CraigB-spinner/Arcade-Spinner/Pics/200mm_Aluminum_Wheel.jpg

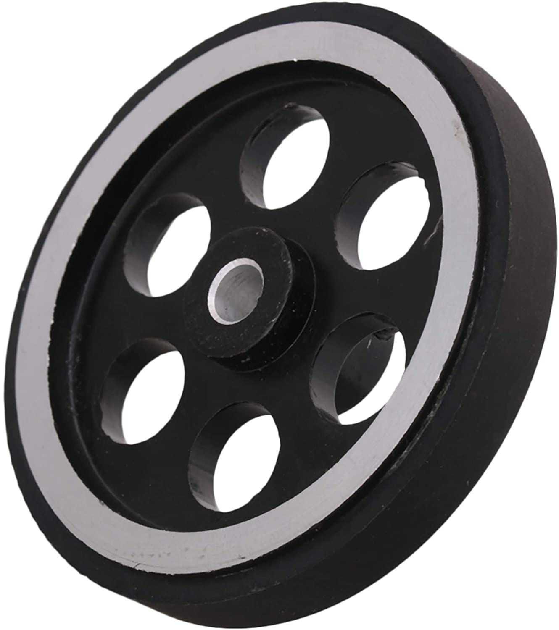
Pics/200mm_Aluminum_Wheel.jpg
