CraigB-spinner/Arcade-Spinner/Pics/200mm_Aluminum_Wheel_2.jpg

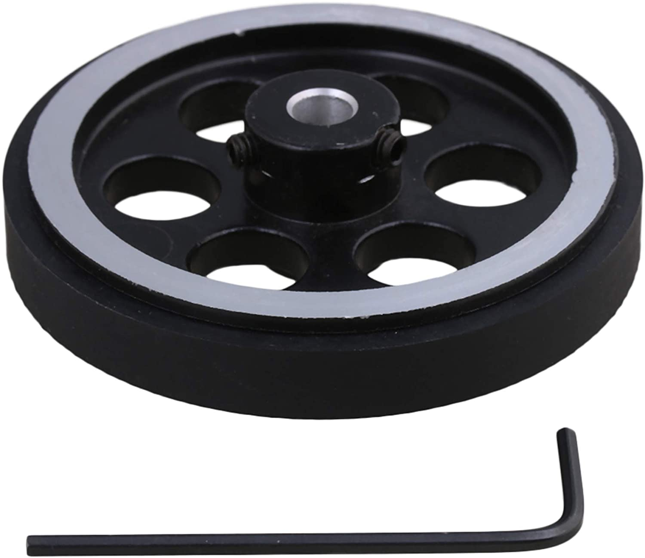
Pics/200mm_Aluminum_Wheel_2.jpg
