CraigB-spinner/Arcade-Spinner/Pics/Adafruit ItsyBitsy - Arduino Micro.jpg

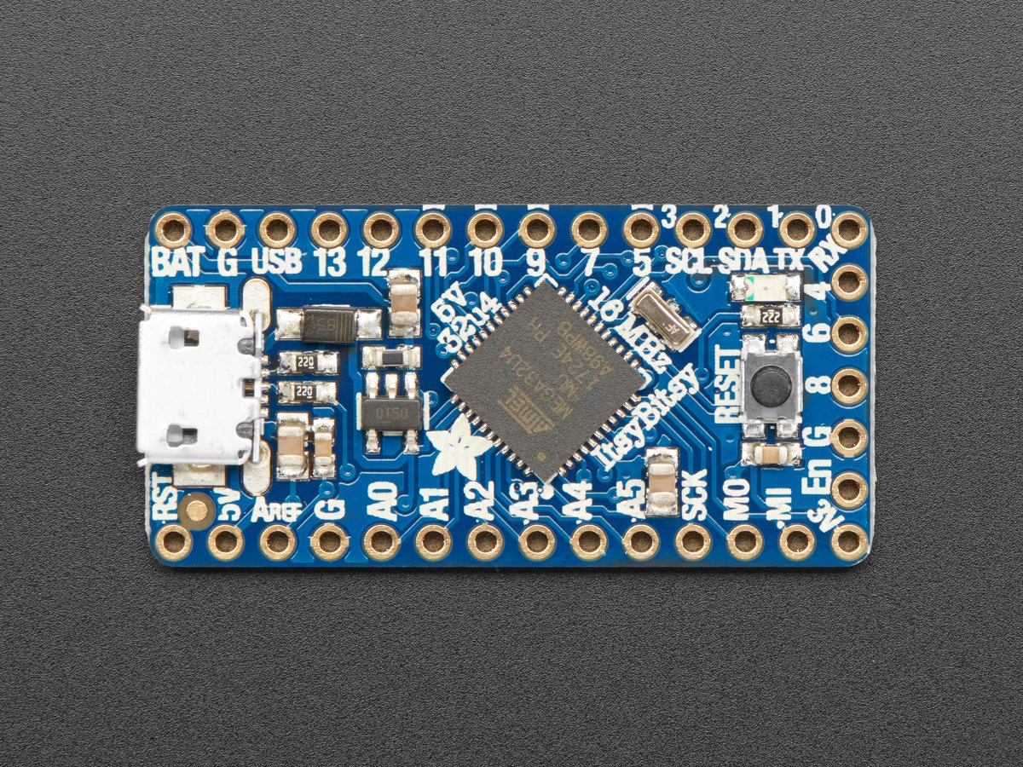
Pics/Adafruit ItsyBitsy - Arduino Micro.jpg
