CraigB-spinner/Arcade-Spinner/Pics/Arduino Micro (Adafruit).jpg

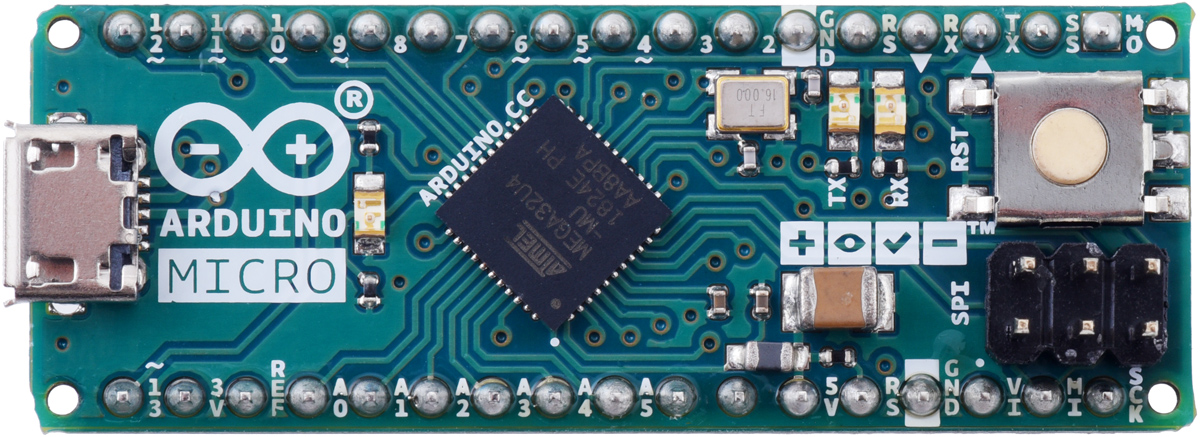
Pics/Arduino Micro (Adafruit).jpg
