CraigB-spinner/Arcade-Spinner/Pics/Arduino Pro Micro Atmega32u4.jpg

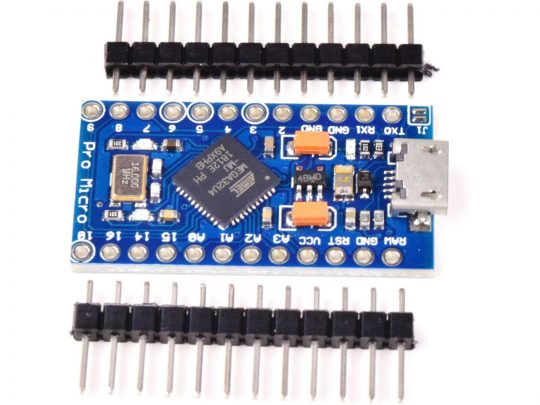
Pics/Arduino Pro Micro Atmega32u4.jpg
