CraigB-spinner/Arcade-Spinner/Pics/Cap_touch.jpg

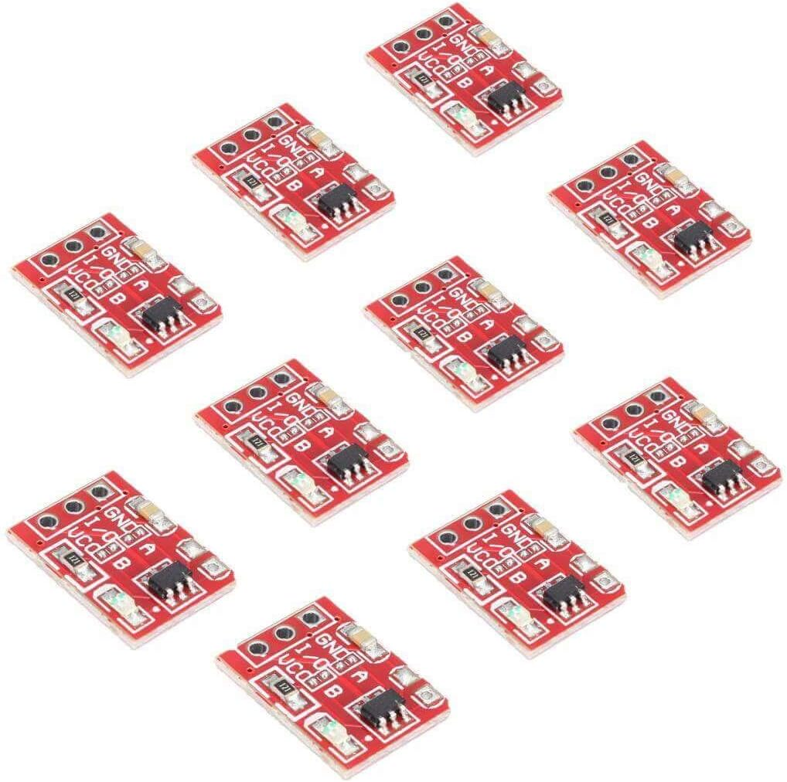
Pics/Cap_touch.jpg
