CraigB-spinner/Arcade-Spinner/Pics/Coin-Play-Exit/IMG_2034.JPG

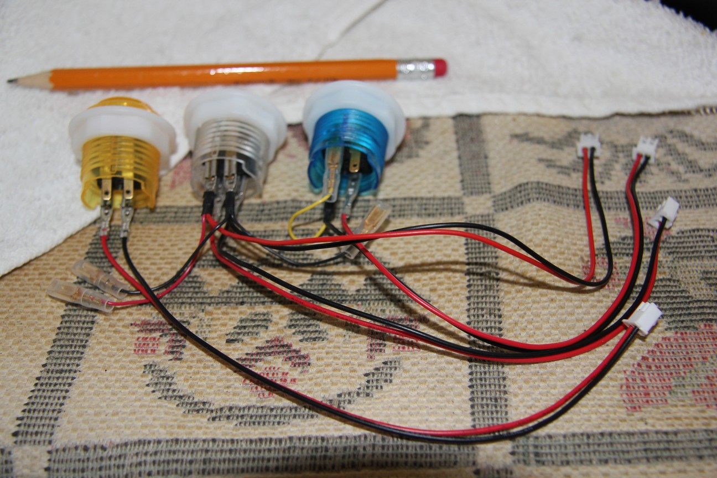
Pics/Coin-Play-Exit/IMG_2034.JPG
