CraigB-spinner/Arcade-Spinner/Pics/Coin-Play-Exit/IMG_2035.JPG

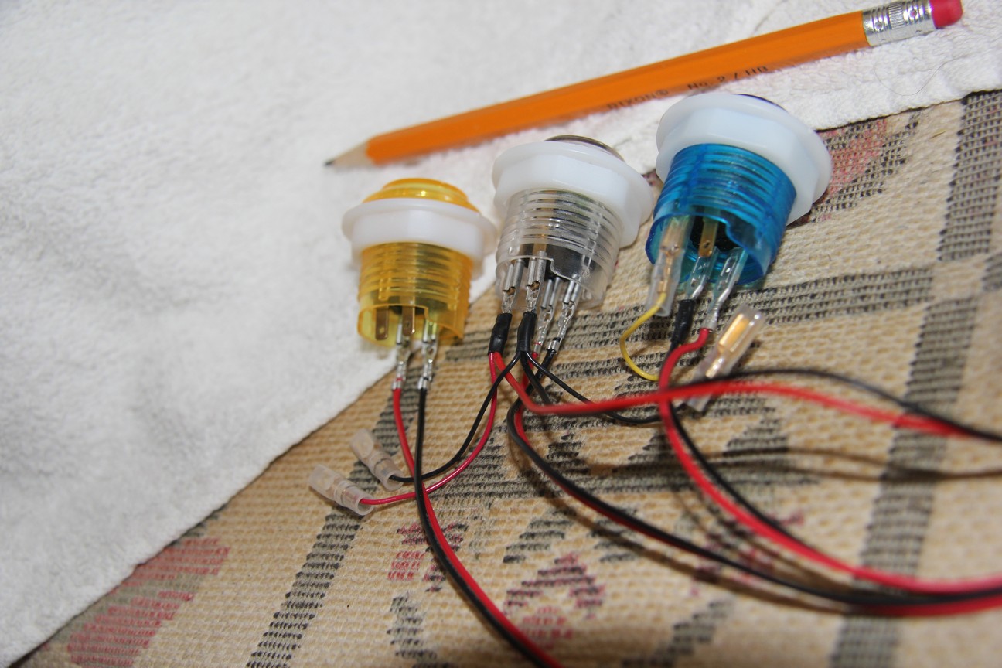
Pics/Coin-Play-Exit/IMG_2035.JPG
