CraigB-spinner/Arcade-Spinner/Pics/CraigB's Spinner.jpg

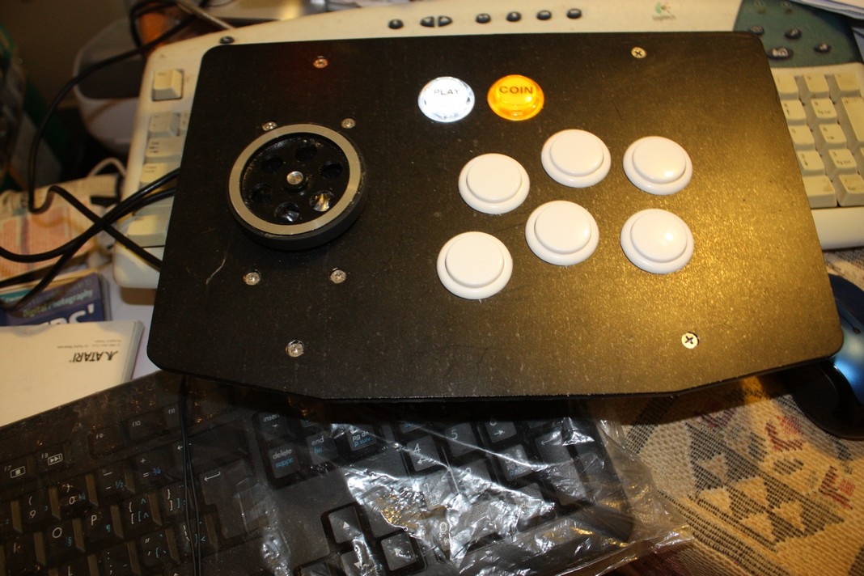
Pics/CraigB's Spinner.jpg
