CraigB-spinner/Arcade-Spinner/Pics/Double Touch.jpg

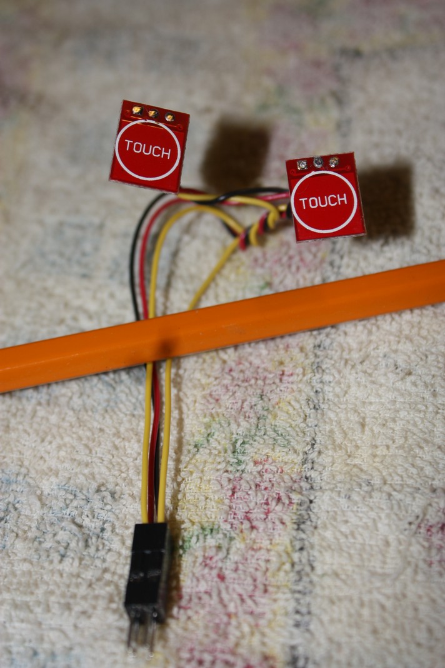
Pics/Double Touch.jpg
