CraigB-spinner/Arcade-Spinner/Pics/Fightbox.jpg

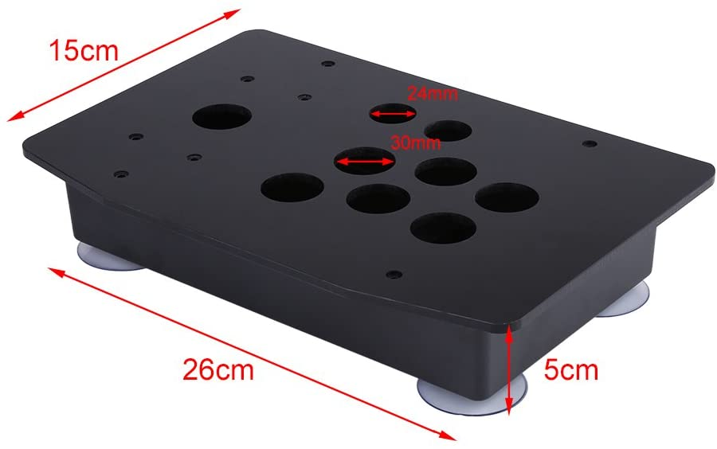
Pics/Fightbox.jpg
