CraigB-spinner/Arcade-Spinner/Pics/Inside guts of spinner.jpg

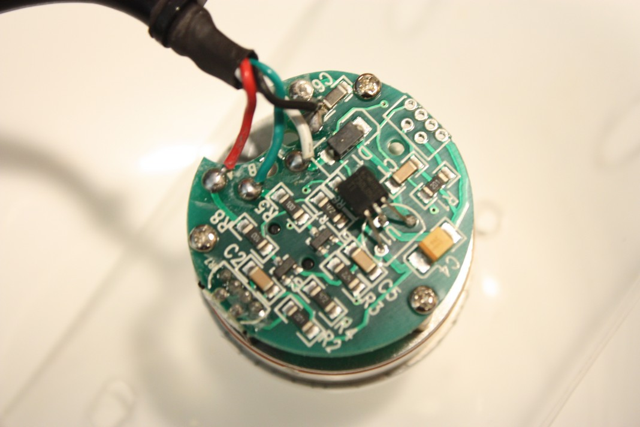
Pics/Inside guts of spinner.jpg
