CraigB-spinner/Arcade-Spinner/Pics/Mxuteuk_Black_AL_Knob_Bottom.jpg

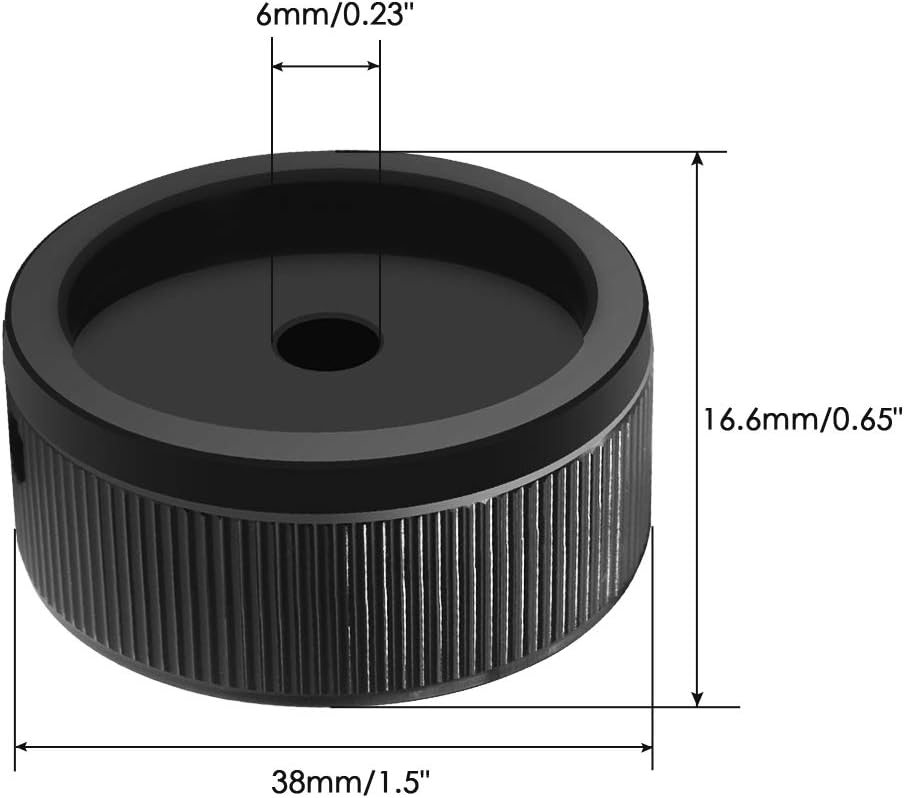
Pics/Mxuteuk_Black_AL_Knob_Bottom.jpg
