CraigB-spinner/Arcade-Spinner/Pics/Mxuteuk_Black_AL_Knob_Side.jpg

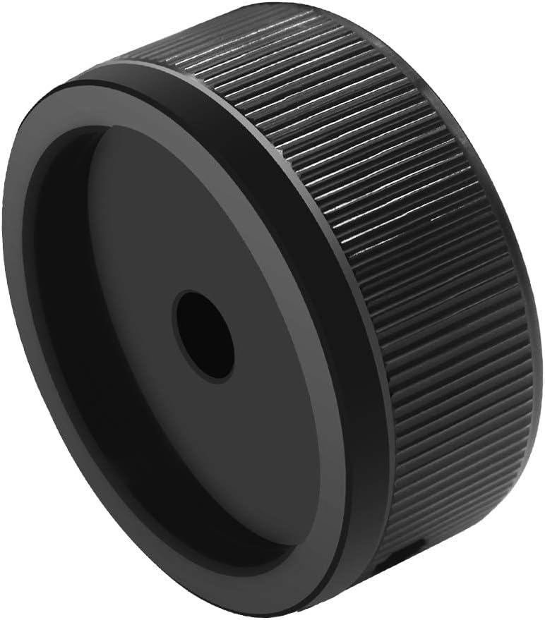
Pics/Mxuteuk_Black_AL_Knob_Side.jpg
