CraigB-spinner/Arcade-Spinner/Pics/Mxuteuk_Black_AL_Knob_Top.jpg

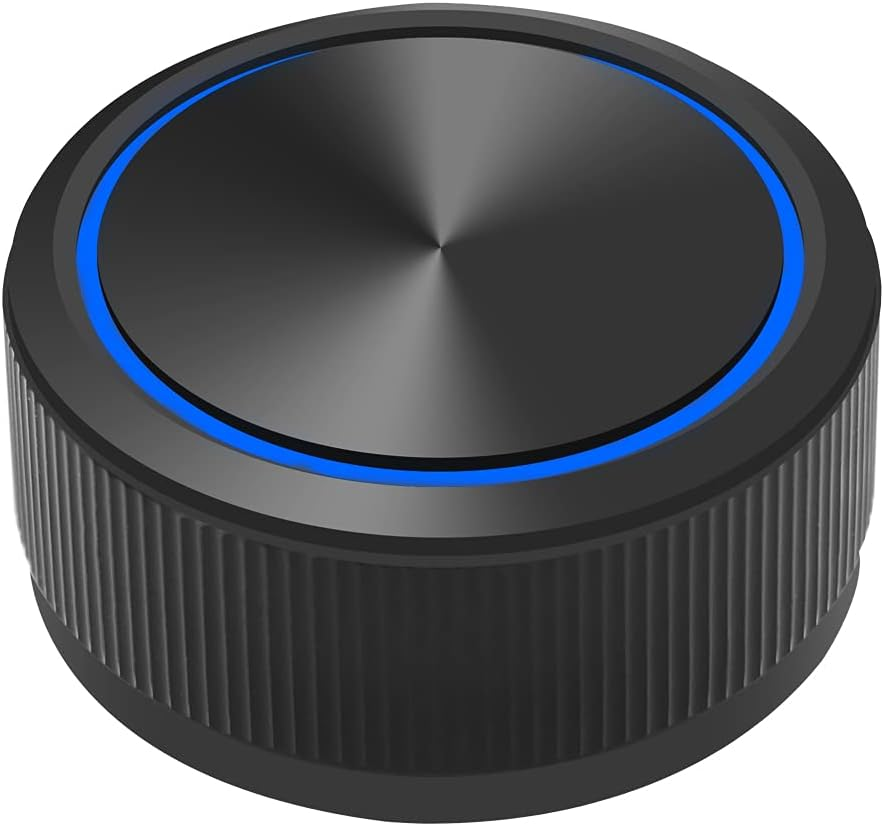
Pics/Mxuteuk_Black_AL_Knob_Top.jpg
