CraigB-spinner/Arcade-Spinner/Pics/Pro_Micro_pinout-Sparkfun-33%.jpg

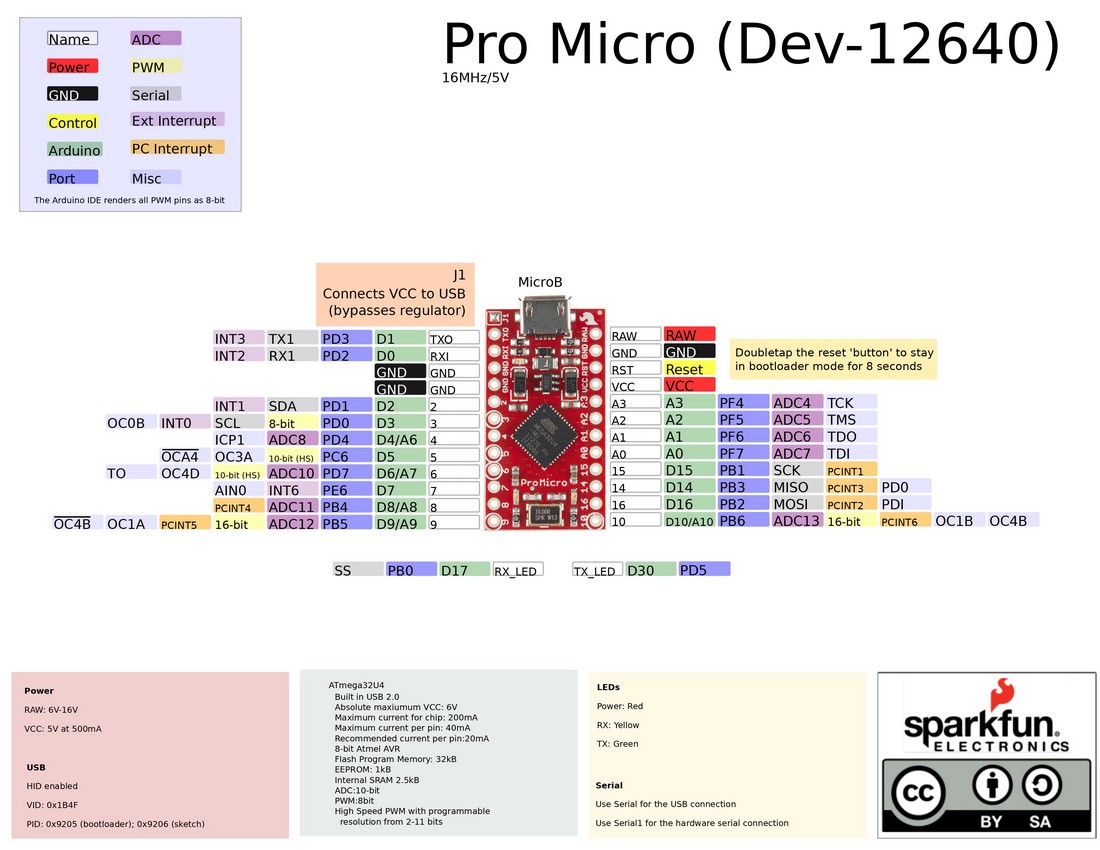
Pics/Pro_Micro_pinout-Sparkfun-33%.jpg
