CraigB-spinner/Arcade-Spinner/Pics/Spin Action Close.jpg

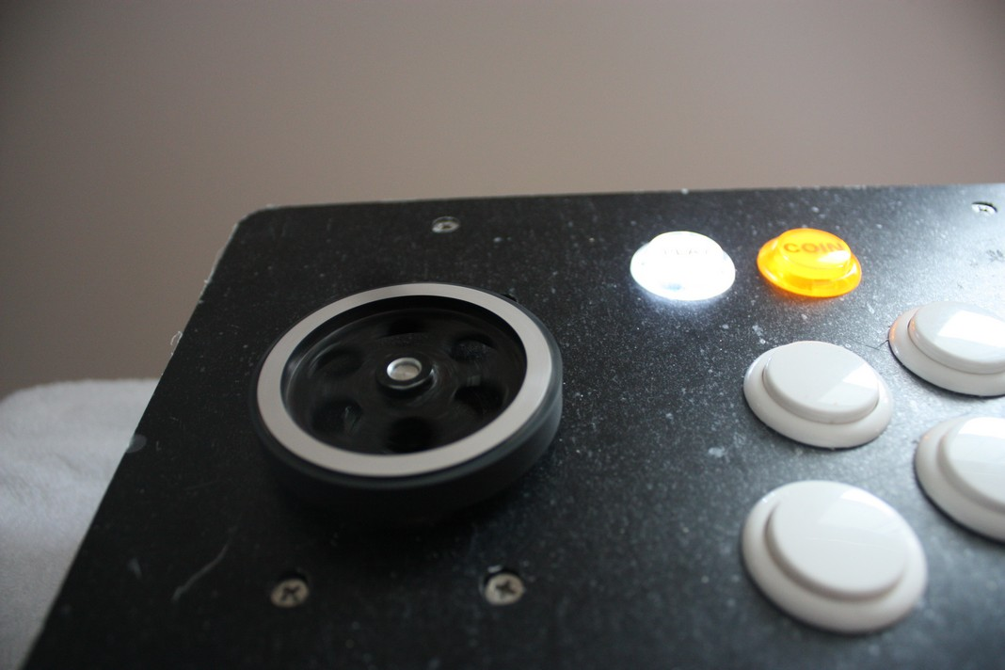
Pics/Spin Action Close.jpg
