CraigB-spinner/Arcade-Spinner/Pics/Spin Action Full.jpg

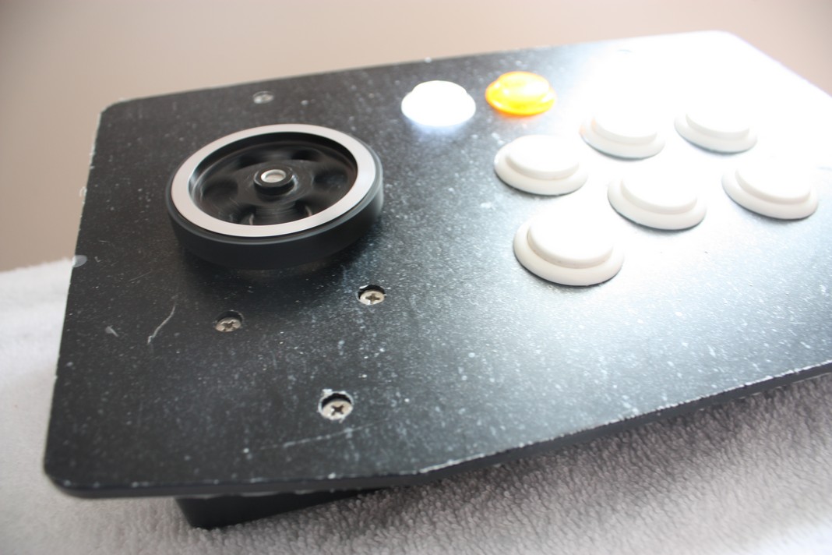
Pics/Spin Action Full.jpg
