CraigB-spinner/Arcade-Spinner/Pics/Spin Full.jpg

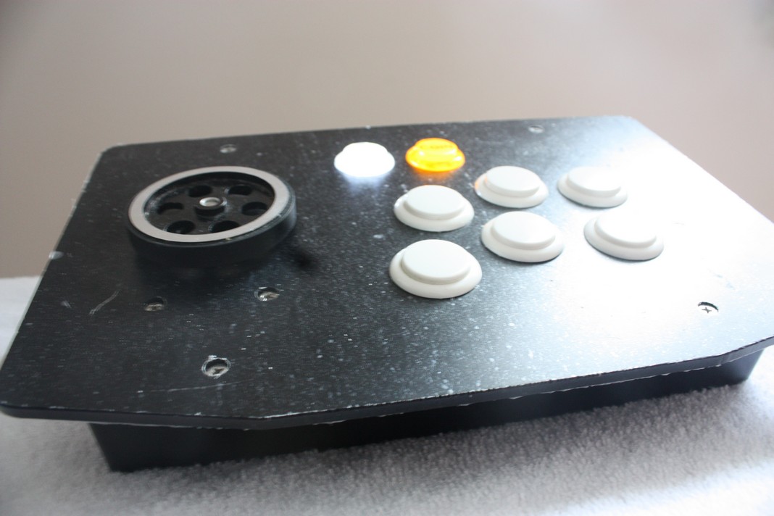
Pics/Spin Full.jpg
