CraigB-spinner/Arcade-Spinner/Pics/Spin HiLite.jpg

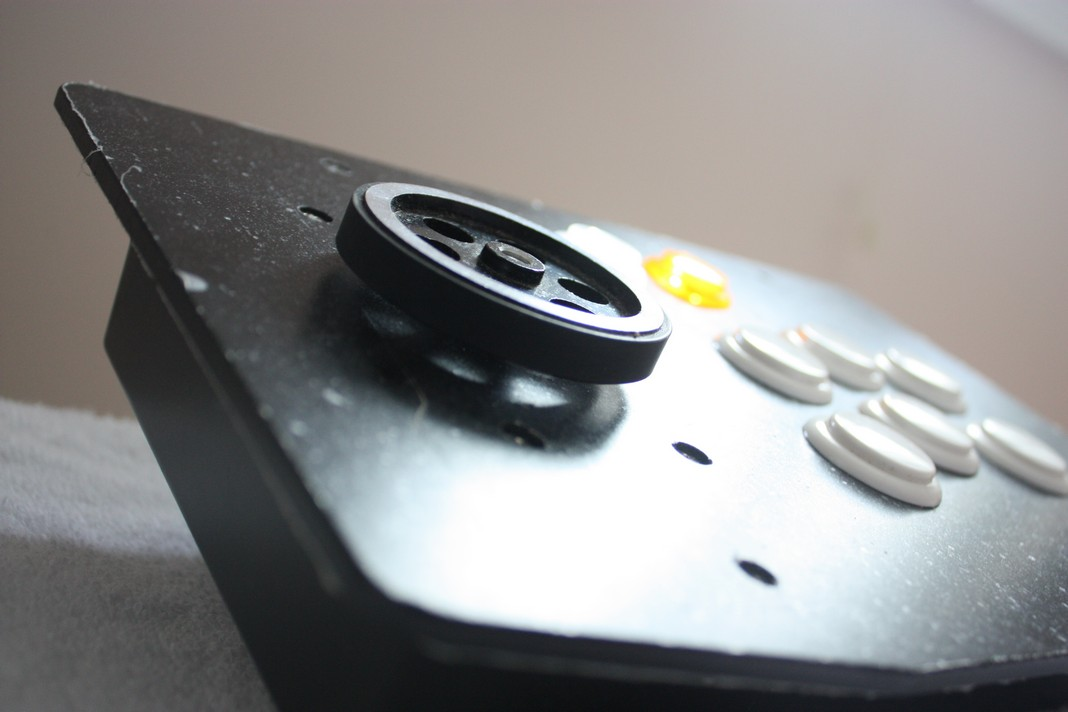
Pics/Spin HiLite.jpg
