CraigB-spinner/Arcade-Spinner/Pics/Spin Shadow.jpg

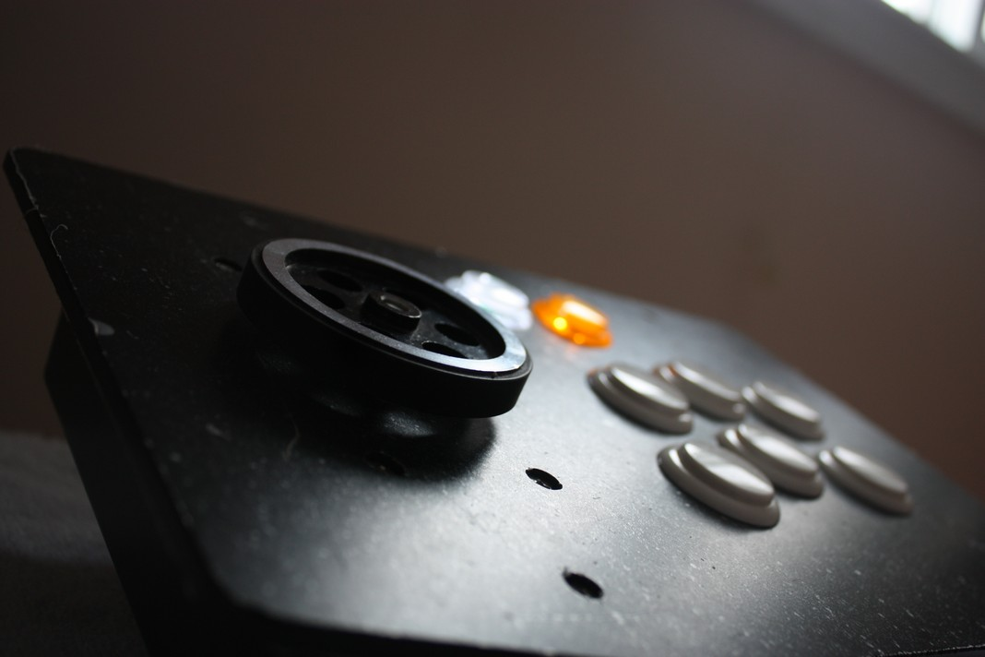
Pics/Spin Shadow.jpg
