CraigB-spinner/Arcade-Spinner/Pics/Spinner Sketch_bb.jpg

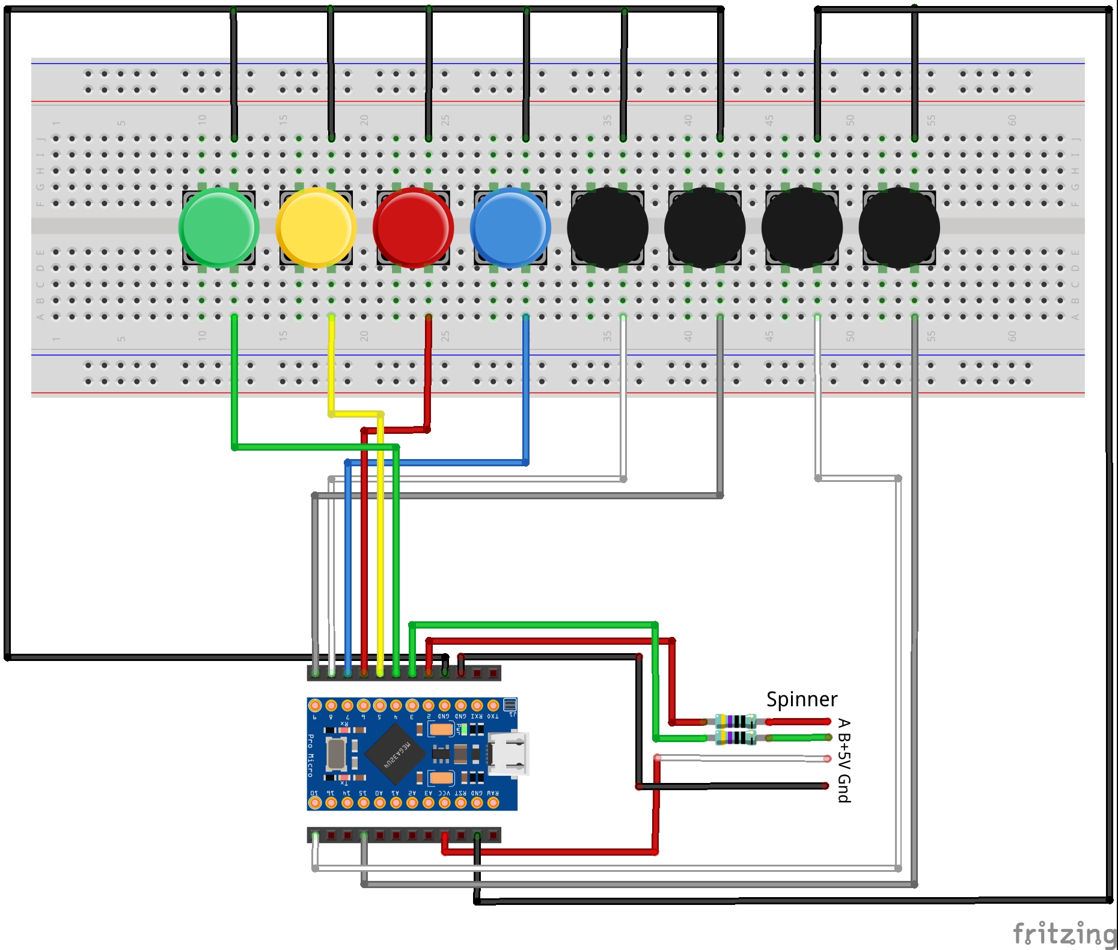
Pics/Spinner Sketch_bb.jpg
