CraigB-spinner/Arcade-Spinner/Pics/Spinner_600ppr.jpg

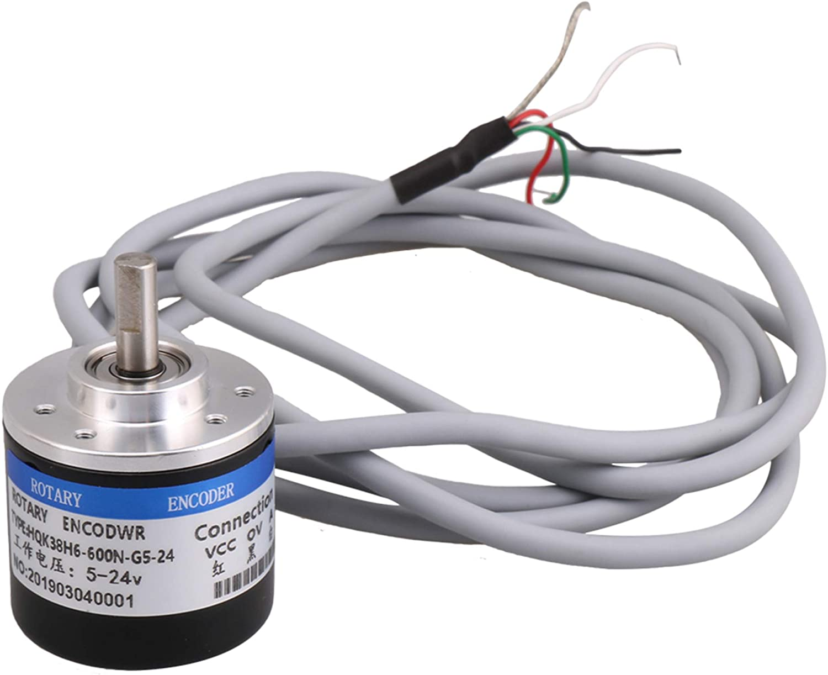
Pics/Spinner_600ppr.jpg
