CraigB-spinner/Arcade-Spinner/Pics/Spinner_600ppr_2.jpg

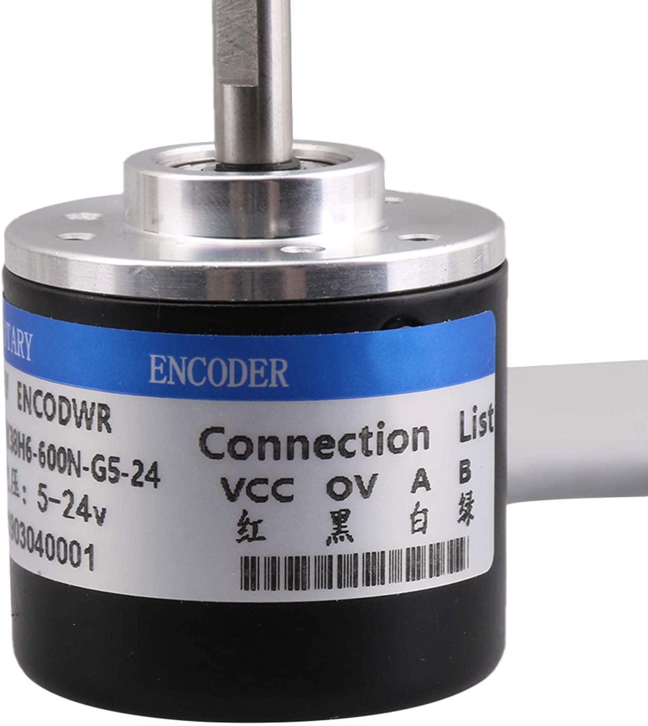
Pics/Spinner_600ppr_2.jpg
