CraigB-spinner/Arcade-Spinner/Pics/TTP223B_chip_side.jpg

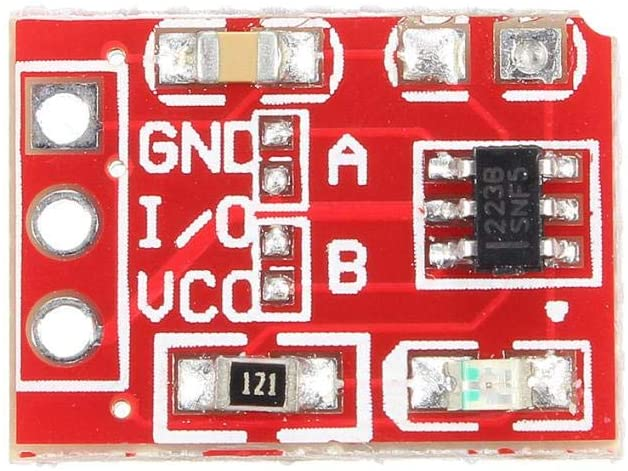
Pics/TTP223B_chip_side.jpg
