CraigB-spinner/Arcade-Spinner/Special Testing Pics/Arduino beauty shot.jpg

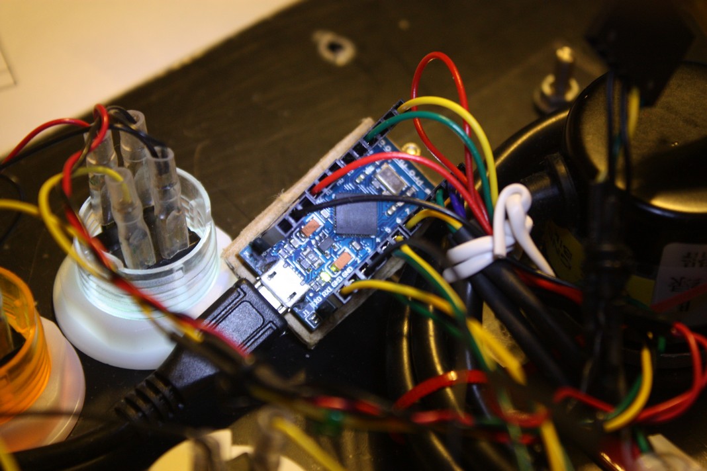
Special Testing Pics/Arduino beauty shot.jpg
