CraigB-spinner/Arcade-Spinner/Special Testing Pics/Inside spaghetti.jpg

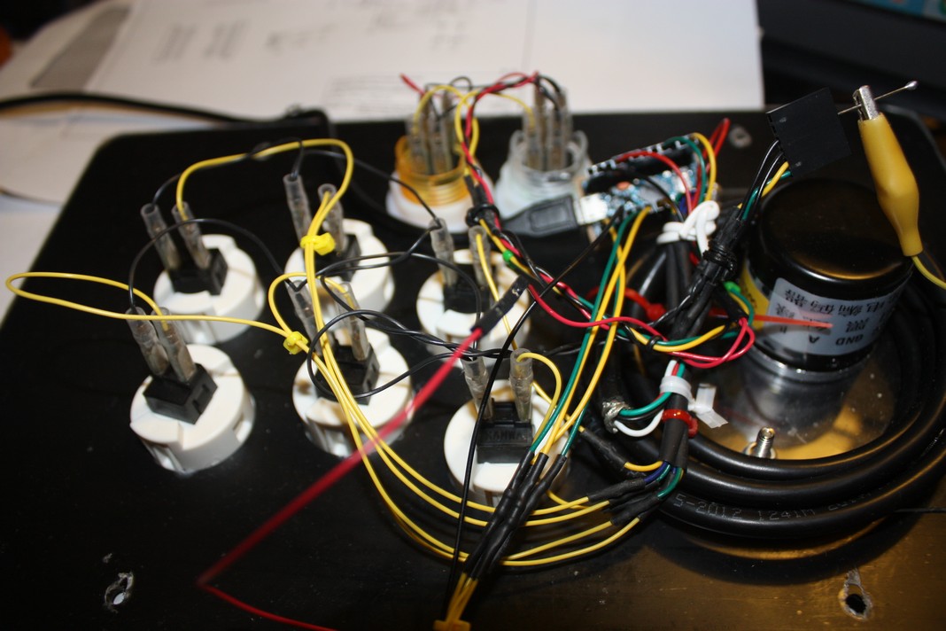
Special Testing Pics/Inside spaghetti.jpg
