CraigB-spinner/Arcade-Spinner/(threads)

Thread 1 (2022-05-21):

want to build: spinner + 2 XY joysticks + buttons (driving controller)

CO-Windler, 2022-05-21:
I want to build a small driving/steering wheel controller compatible particularly with "Hard Drivin" and "Pole Position" variants on MAME, those need an endless 360° steering wheel (i.e. spinner) and 2 analogue "pedals" (brake and accelerator) plus a couple of digital buttons. Particularly "Hard Drivin" additionally needs an analogue XY joystick as a stick shifter, so I would need basically hardware that combines 2 PC joysticks and a trackball/ball mouse (containing 2 rotary encoders).

The device shall not become a fullsize simulator cockpit with steering wheel, but a compact controller similar like the Colecovision "Turbo" steering wheel/"Expansion Module 2". As a yogi I am a floorsitter living in a chairfree home, so it shall not need actual foot pedals (although I own plenty of volume pedals from my music keyboard collection); instead it will likely have pressure sensitive buttons or levers.

Possibly I will mod one of those baby steering wheel toys like this.

[i]Toy Steering Wheel Controller - Mario Kart: Double Dash!![/i]
https://www.youtube.com/watch?v=iNuI0311-qA

In my electronics parts box I also have a tube radio tuning knob assembly with bearing and big flywheel that could become a nice spinner.

(I websearched plenty of commercially available gamepads for for the electronic part but found nothing suitable. Modern PC mice and trackballs have optical sensors those can not easily mechanically separate X and Y motion.)

Can the code be used to handle a spinner+2 analogue joysticks+buttons combination with USB connector for PC?

CraigB-spinner, 2023-03-07:
Yes, Pro Micro has ability for two spinners or one trackball, 10 digital buttons, 4 analogues (2 joysticks or 4 pots)
Sparkfun had an analogue joystick mouse project.
Warning don't overload the rotary encoder bearing with a heavy wheel or you will be buying twice. Think indirect drive through a gear, pulley, chain, or friction wheel. The steering wheel can be supported by its own bushing/bearings.
I used a 200mm (2.5" dia.) rubber/aluminum rotary encoder wheel.

Thread 2 (2022-12-29):

Can I drive Egstarts2 spinner ?

Giandj, 2022-12-29:
Hi CraigB I have a question:
I have an Egstarts2 spinner (normally compatibile only with arcade 1up 12 in 1 board...over 85 euro in Italy...
I have also an arduino Pro Micro..
So the question is Can I use this code To program my Arduino to connect as an Hid Device egstarts2 spinner on my raspberry Pi4 with retropie 4.8.2 and play with arkanoid? Or Egstarts2 spinner is not recognized by your program code (I intend to use tour Code Spinnet without buttons (because on my arcade buttons are already present and I don't need extra buttons mapped over spinner)...
Thank you

Giandj, 2023-01-01:
Hi Craig I have tried your arcade spinner without buttons code with an Arduino Pro Micro 5v , my Arduino is viewed By IDE sw like "Leonardo" and not like pro micro...(impossible ti compie program If I set different arduino board)...
I don't Know who is the producer of my board (my "pro micro" is a blue board not a red like sparkforfun board)...
I have also used Egstarts (working with 3.3V by external power) spinner with pro micro connecting pin 2 and 3 for rotation left or right...but the spinner works only in ONE Direction  right X axis (x++)...tested on my pc...
if i invert pin 2 and 3 works only on left X axis (x--)...what the mistake?
So if i nove clockwise or anticlockwise the spinner moves only in 1 sense...not in back...

Giandj, 2023-01-06:
Hi CraiG finally i tried Mister.ino and now my spinner works well...
My arduino was a clone of pro micro (but not sparkfun red pro micro board)
So after many and many test to configure (What?) Board in IDE software I finally programmed like Arduino Leonardo ...my pro micro 5v 16mhz Atmega32u4  blu board (identical to pro micro red board selled by sparkfun .com) is total compatibile in IDE with Leonardo and programmer must be set in IDE software like "Atmega32U4 as ISP"
Otherwise isn't programmable...
A question I also tried to connect EGstart2 Spinner (normally compatibile with Arcade 1up 12 in 1 board)...but this spinner won't works...
I have also set 512 Pulse per rotation on this spinner but nothing happens why ? Have You an Idea ? In tour spinner.ino or MistEr.ino code I cannot Undarstand at what speed or what frequency Pin 2 and Pin 3 are listened by intetrupt... maybe the Egstarts2 spinner is too low ? Or maybe is because Egstarts2 spinner works with 3.3v ? instead my working (with Mister.ino) rotary encoder use 5v ...
I don't know...

CraigB-spinner, 2023-03-07:
Sorry, usually monitor my second YouTube comments, didn't see message until today.
I posted my code in fall of 2020 from summer/fall of 2019 build of Spinner and Trackball.
The spinner was a four month project, while the trackball was a three month project.

Pro Micro boards, the inventor Sparkfun made a smaller version of Arduino Micro with fewer pins.
Arduino Srl worked will Adafruit to make the Arduino Micro and Adafruit made their version, ItsyBitsy, and of course China has dozens of clones. I used a Chinese clone from universal-solder.ca which is better quality clone of Sparkfun's board. The bootloader Universal Solder uses emulates Sparkfun's bootloader. I have purchased lower quality Chinese Pro Micro clones that use Leonardo's bootloader. You must setup Arduino IDE to communicate to the specific bootloader to work, like calling your kid's name. It is all a learning experience with micro chip shortages due to over demand and maxed out manufacturing capacity.

Most devices work on 5V except MCUs that are 3.3V and will require level converters or pop goes your MCU.
I almost bought the wrong voltage Pro Micro when first shopping for the spinner project.
You can also have voltage drop-outs from 5V down to 3V and the MCU can not tell the difference between a Hi and Lo. I had this issue when doing my trackball project with added RGB (7 colour) lighting under the ball. Use good quality USB cables for high current flow and not just 500mA standard 2.0. My mouse would stutter in a windows screen.

My MCU has 2 Leds lit, Power and Tx (blinks with movement); Rx (is off unless downloading code).

The one-way spinner could be a software typo. I have 4-5 versions of the software but all should work similar for movement; however, there are directive options that turn code usage on and off when compiling and different code could be compiled by mistake with the typo. The other issue can be your 3.3V statement and improper levels but this would be consistent across code versions. Both pins 2 and 3 must produce quadrature signals into the MCU or there would be no movement.

EGstart2 Spinner ???
GRS (Glen's Retro Show) made by ThunderSticks makes two versions Arcade-1up and Button hole standard USB. The original Arcade-1up design must output a serial UART protocol like old RS-232 serial mouses. The revised Spinner uses USB protocol. Neither will need my code as the MCU is pre-programmed and built-in. The Arcade-1up 12-in-1 board is requires with original spinner to convert (using another MCU) to another protocol, assuming the special Arcade-1up 12-in-1 machine uses USB (or PS/2?).
EGstart is a Chinese cloner and quality control is of lower standards, hence, cost reduction.
My Pro Micro and software will work with any Quadrature rotary encoder 200/360/600/1200/etc from Ultimarc, Groovy Game Gear, or Chinese discount rotary encoder.

CraigB-spinner, 2023-03-07:
Retested Spinner_No-Button.ino and it works fine; did a quick update to allow D16 or D17 to flip x/y axis, so I could complete the test. My box only has a single touch button installed, it is normally configured to temporary simulate four buttons as a joystick D-pad. RetroPie requires a joystick for navigation.

Thread 3 (2024-02-04):

Works with arcade wheel

mrchrisster, 2024-02-04:
Hey Craig,

I'm planning on using your spinner project for my arcade cabinet. It's a Continental Circuit.

Do you have any idea if this would work? The steering wheel gets 5v and gnd already so I just wanted to connect steer 1 and steer 0 and then the rest of the buttons.

[Cont-Circ-cab-schematic.pdf](https://github.com/CraigB-spinner/Arcade-Spinner/files/14157524/Cont-Circ-cab-schematic.pdf)

CraigB-spinner, 2025-02-22:
This spinner is a U-HID for PC/MAC or RaspberryPI or other android/linux boxes that support USB mice and sticks for buttons.
The circuit diagram is legacy arcade using direct input for quadrature input encoding or pulses for left or right.

mrchrisster, 2025-02-23:
It worked very well. I'm using a heavily modified version of your script on the Arcade for about a year now

Thread 4 (2024-09-21):

12 button code for using A0-A3 on Pro Micro - I used them for a D-pad

Godzilla-ZZ, 2024-09-21:
/*   Arcade Spinner v2.01
*    Craig B  - (craigbspinner@gmail.com)
*    Copyright 2018 Joe W (jmtw000 a/t gmail.com)
*                   Craig B - based on Spinner code from early June 2019
*    Copyright 2019 Craig B - Updated code from late June 2019,
*                             Added spinner movement ACCM/DROP,
*                             Optimized code speed by changing if logic to case statement logic for Button validation of port bits.
*                   Craig B - Added code for spinner movement NORM/ACCS/ACCX, RetroPi fix - July 2019 
*                   Craig B - Added code for spinner axis change from early Sept 2020
*
*    This program is free software: you can redistribute it and/or modify
*    it under the terms of the GNU General Public License as published by
*    the Free Software Foundation, either version 3 of the License, or
*    (at your option) any later version.
*
*    This program is distributed in the hope that it will be useful,
*    but WITHOUT ANY WARRANTY; without even the implied warranty of
*    MERCHANTABILITY or FITNESS FOR A PARTICULAR PURPOSE.  See the
*    GNU General Public License for more details.
*
*    You should have received a copy of the GNU General Public License
*    along with this program.  If not, see <https://www.gnu.org/licenses/>.
*/

#include "Mouse.h"
#include <Joystick.h>

/*   RetroPie mods - Arduino IDE -> Tools, Get Board Info
*    VID: 1B4F
*    PID: 9206
*    Add the following to /boot/cmdline.txt -- just add a space to the end of the existing entry, so it is all on one line):
*    usbhid.quirks=0x16c0:0x05e1:0x040
*    The first two numbers are the vendor ID 16c0 and product ID 05e1.
*/

// Port Bit/Pin layout
//      Bit - 76543210 - Silk screen ## - Micro-Controller
#define xPD3 0b00001000 //Digital Pin 0  - Micro/PRO Micro - RX,  INT2
#define xPD2 0b00000100 //Digital Pin 1  - Micro/PRO Micro - TX,  INT3
#define xPD1 0b00000010 //Digital Pin 2  - Micro/PRO Micro - SDA, INT0
#define xPD0 0b00000001 //Digital Pin 3  - Micro/PRO Micro - SCL, INT1
#define xPD_10 (xPD1 | xPD0)
#define xPD_32 (xPD3 | xPD2)
#define xPD4 0b00010000 //Digital Pin 4  - Micro/PRO Micro
#define xPC6 0b01000000 //Digital Pin 5  - Micro/PRO Micro
#define xPD7 0b10000000 //Digital Pin 6  - Micro/PRO Micro
#define xPE6 0b01000000 //Digital Pin 7  - Micro/PRO Micro
#define xPB4 0b00010000 //Digital Pin 8  - Micro/PRO Micro
#define xPB5 0b00100000 //Digital Pin 9  - Micro/PRO Micro
#define xPB6 0b01000000 //Digital Pin 10 - Micro/PRO Micro
#define xPB7 0b10000000 //Digital Pin 11 - Micro
#define xPD6 0b01000000 //Digital Pin 12 - Micro
#define xPC7 0b10000000 //Digital Pin 13 - Micro
#define xPB3 0b00001000 //Digital Pin 14 - PRO Micro
#define xPB1 0b00000010 //Digital Pin 15 - PRO Micro
#define xPB2 0b00000100 //Digital Pin 16 - PRO Micro
#define xPF7 0b10000000 //Digital Pin A0 - PRO Micro
#define xPF6 0b01000000 //Digital Pin A1 - PRO Micro
#define xPF5 0B00100000 //Digital Pin A2 - PRO Micro
#define xPF4 0B00010000 //Digital Pin A3 - PRO Micro

//Mouse movement - pick one to compile specific code inside loop()
//#define NORM   //Mouse movement Normal; every interrupt processed; maybe lag in fast movement, 2 pulse = 2 move
//#define DROP   //Mouse movement Drop; drop extra interrupts processed; smooth movement, no lag, 2 - 2n+1 pulse = 1 move
//#define ACCS   //Mouse movement Accelerated; every interrupt processed but accelerated movement, no lag x1, 1 pulse = 1 move
#define ACCM   //Mouse movement Accelerated; every interrupt processed but accelerated movement, no lag x2, 2 pulse = 1 move
//#define ACCX   //Mouse movement Accelerated; every interrupt processed but accelerated movement, no lag x4, 4 pulse = 1 move

#define pinA 2    //The pins that the rotary encoder's A and B terminals are connected to.
#define pinB 3

#define maxBut 14   //Update lastButtonState array below when changing number of elements.
#define axisFlip 6  //Special flip button (button offset: 0 thru 9) - comment out if 'x/y-axis' feature not required by you.

//Create a Joystick object.
Joystick_ Joystick(JOYSTICK_DEFAULT_REPORT_ID,JOYSTICK_TYPE_GAMEPAD,
  maxBut, 0,             // Button Count, Hat Switch Count
  true, true, false,     // X, but no Y or Z Axis. We need at least one axis even though it's not really used.
  false, false, false,   // No Rx, Ry, or Rz
  false, false,          // No rudder or throttle
  false, false, false);  // No accelerator, brake, or steering;

//The previous state of the AB pins
volatile int prevQuadratureX = 0;

//Keeps track of how much the encoder has been moved
volatile int rotPositionX = 0;
volatile int rotMultiX = 0;
#ifdef axisFlip
volatile int xAxis = 1;
volatile int yAxis = 0;

// Last state of 10 buttons (update array for your maxBut buttons)
// Since Button Port Bits are set to 1 to activate (pull-up resistors for input),
// the press state is low, and not pressed is high.
// axisFlip 6 (button offset: 0 thru 9)
int lastButtonState[maxBut] = {1,1,1,1,1,1,1,0,1,1,1,1,1,1};
#else
int lastButtonState[maxBut] = {1,1,1,1,1,1,0,0,1,1,1,1,1,1};
#endif

void setup() {
  //No need to set the pin modes with DDRx = DDRx | 0b00000000 as we're using all input and that's the initial state of the pins

  //Use internal input resistors for all the pins we're using
  PORTD = 0b10010011; //Digital pins D2(1), D3(0), D4(4), and D6(7).
//PORTB = 0b01110111; //Digital pins D8(4), D9(5), D10(6), and D15(1). {D16(2), D14(3)}; D16 requires PB0 set high(master) - (Button 5, 6, 9 & 10)
#ifdef axisFlip       // D16 - PB2 & PB0 hi
  PORTB = 0b01110111; //(Button 5, 6, 7-Axis, 9 & 10)
#else
  PORTB = 0b01110010; //(Button 5, 6, 9 & 10)
#endif
  PORTC = 0b01000000; //Digital pin D5(6)
  PORTE = 0b01000000; //Digital pin D7(6)
  PORTF = 0b11110000; //Digital pin A0(7)(UP) & A1(6)(Down). A2(5)(Right), A3(4)(Left)

  //Start the joystick
  Joystick.begin();

  //Center the X axis on the joystick (Raspberry Pi/RetroPi requires two axises to be defined)
  Joystick.setXAxis(511);
  Joystick.setYAxis(511);

  //Set up the interrupt handler for the encoder's A and B terminals on digital pins 2 and 3 respectively. Both interrupts use the same handler.
  attachInterrupt(digitalPinToInterrupt(pinA), pinChange, CHANGE);
  attachInterrupt(digitalPinToInterrupt(pinB), pinChange, CHANGE);

  //Start the mouse
  Mouse.begin();
}

//Interrupt handler
//Digital pins 2 and 3 are used for spinner rotary output as they are interrupt driven.
void pinChange() {
  //Set currQuadratureX to state of rotary encoder terminals A & B from input of PORTD bits 0 & 1 (digital pins 2 and 3)
  //You could do int currQuadratureX = (digitalRead(pinA) << 1) | digitalRead(pinB); to get the same thing, but it would be much slower.
  //Read current state 00AB.
  int currQuadratureX = PIND & xPD_10;

  //Store comboQuadratureX with previous and current quadrature rotary encoder states together.
  //Combined previous/current states form two groups of four unique bit patterns indicating direction of movement.
  //Shift left 2 bits: 00AB <- AB00 to store current state as previous state.
  int comboQuadratureX  = (prevQuadratureX << 2) | currQuadratureX;

  //Rotate to the right, Clockwise
  //State 00AB, A leads B. A0 -> AB -> 0B -> 00 0b0010 0b1011 0b1101 0b0100
  if(comboQuadratureX == 0b0010 || comboQuadratureX == 0b1011 ||
     comboQuadratureX == 0b1101 || comboQuadratureX == 0b0100)
    rotPositionX++;                   //update the position of the encoder

  //Rotate to the left, Counter Clockwise
  //State 00AB, B leads A. 0B -> AB -> A0 -> 00 0b0001 0b0111 0b1110 0b1000
  if(comboQuadratureX == 0b0001 || comboQuadratureX == 0b0111 ||
     comboQuadratureX == 0b1110 || comboQuadratureX == 0b1000)
    rotPositionX--;                   //update the position of the encoder

  //Save the previous state of the A and B terminals for next time
  prevQuadratureX = currQuadratureX;
}

void loop(){
  int currentButtonState;

#ifdef NORM
  //If the encoder has moved 2 or more transitions move the mouse in the appropriate direction
  //and update the position variable to reflect that we moved the mouse. Smooth movement but lags.
  if(rotPositionX >= 2) {
#ifdef axisFlip
    Mouse.move(xAxis,yAxis,0);
#endif
#ifndef axisFlip
    Mouse.move(1,0,0);
#endif
    rotPositionX -= 2;
  } else if(rotPositionX <= -2) {
#ifdef axisFlip
    Mouse.move(-xAxis,-yAxis,0);
#endif
#ifndef axisFlip
    Mouse.move(-1,0,0);
#endif
    rotPositionX += 2;
  }
#endif

#ifdef DROP
  //If the encoder has moved 2 or more transitions move the mouse in the appropriate direction
  //and update the position variable to reflect that we moved the mouse. Smooth drop extra moves.
  if(rotPositionX >= 2) {
#ifdef axisFlip
    Mouse.move(xAxis,yAxis,0);
#endif
#ifndef axisFlip
    Mouse.move(1,0,0);
#endif
    rotPositionX = 0;
  } else if(rotPositionX <= -2) {
#ifdef axisFlip
    Mouse.move(-xAxis,-yAxis,0);
#endif
#ifndef axisFlip
    Mouse.move(-1,0,0);
#endif
    rotPositionX = 0;
  }
#endif

#ifdef ACCS
  //If the encoder has moved 1 or more transitions move the mouse in the appropriate direction
  //and update the position variable to reflect that we moved the mouse. Accelerated move.
  if(rotPositionX != 0) {
#ifdef axisFlip
    int x = (xAxis) ? rotPositionX : 0;
    int y = (yAxis) ? rotPositionX : 0;
    Mouse.move(x,y,0);
#endif
#ifndef axisFlip
    Mouse.move(rotPositionX,0,0);
#endif
    rotPositionX = 0;
  }
#endif

#ifdef ACCM
  //If the encoder has moved 2 or more transitions move the mouse in the appropriate direction
  //and update the position variable to reflect that we moved the mouse. Accelerated move.
  if(rotPositionX >= 2 || rotPositionX <= -2) {
    rotMultiX = rotPositionX >> 1;
#ifdef axisFlip
    int x = (xAxis) ? rotMultiX : 0;
    int y = (yAxis) ? rotMultiX : 0;
    Mouse.move(x,y,0);
#endif
#ifndef axisFlip
    Mouse.move(rotMultiX,0,0);
#endif
    rotPositionX -= (rotMultiX << 1);
  }
#endif

#ifdef ACCX
  //If the encoder has moved 4 or more transitions move the mouse in the appropriate direction
  //and update the position variable to reflect that we moved the mouse. Accelerated move.
  if(rotPositionX >= 4 || rotPositionX <= -4) {
    rotMultiX = rotPositionX >> 2;
#ifdef axisFlip
    int x = (xAxis) ? rotMultiX : 0;
    int y = (yAxis) ? rotMultiX : 0;
    Mouse.move(x,y,0);
#endif
#ifndef axisFlip
    Mouse.move(rotMultiX,0,0);
#endif
    rotPositionX -= (rotMultiX << 2);
  }
#endif

  //Iterate through the 10 buttons (0-9) assigning the current digital state of pin for each button,
  //HIGH(0b00000001) or LOW(0b00000000), to currentState variable.
  //Note: Pro Micro boards use various ports to access different digital pins.
  //Buttons 1-6, plus 9-select(coin), and 10-start(player) used; buttons 7 & 8 unused
  //Using digital pins 4, 5, 6, 7, 8, 9, 10, and 15 on Pro Micro board. See silk screening.
  //Pins 16 and 14 are free to use.
  //Pins 2 and 3 are used for spinner rotary output as they are interrupt driven.
  int button = 0;
  do {
    switch ( button ) {
      case 0:  //on digital pin 4, PD4 - Arcade Button 1
        currentButtonState = (PIND & xPD4) >> 4;
        break;
      case 1:  //on digital pin 5, PC6 - Arcade Button 2
        currentButtonState = (PINC & xPC6) >> 6;
        break;
      case 2:  //on digital pin 6, PD7 - Arcade Button 3
        currentButtonState = (PIND & xPD7) >> 7;
        break;
      case 3:  //on digital pin 7, PE6 - Arcade Button 4
        currentButtonState = (PINE & xPE6) >> 6;
        break;
      case 4:  //on digital pin 8, PB4 - Arcade Button 5
        currentButtonState = (PINB & xPB4) >> 4;
        break;
      case 5:  //on digital pin 9, PB5 - Arcade Button 6
        currentButtonState = (PINB & xPB5) >> 5;
        break;
#ifdef axisFlip
      case 6:  //on digital pin 16, PB2 - Special Axis Button (internal function) - requires PB0 set to master or high
        currentButtonState = (PINB & xPB2) >> 2;
        break;
#endif
//      case 7:  //on digital pin 14, PB3 - 2nd Special Button
//        currentButtonState = (PINB & xPB3) >> 3;
//        break;
      case 8:  //on digital pin 10, PB6 - COIN/Select Button 9
        currentButtonState = (PINB & xPB6) >> 6;
        break;
      case 9:  //on digital pin 15, PB1 - PLAYER/Start Button 10
        currentButtonState = (PINB & xPB1) >> 1;
        break;
      // Set Dpad to A0-A3
      case 10: //on digital pin A0, PF7
        currentButtonState = (PINF & xPF7) >> 7;
        break;
      case 11: //on digital pin A1, PF6
        currentButtonState = (PINF & xPF6) >> 6;
        break;
      case 12: //on digital pin A1, PF5
        currentButtonState = (PINF & xPF5) >> 5;
        break;
      case 13: //on digital pin A1, PF4
        currentButtonState = (PINF & xPF4) >> 4;
        break;
      default: //Extra digital pins 16, PB2 and 14, PB3
        currentButtonState = 0b00000000;
        break;
    }

    //If the current state of the pin for each button is different than last time, update the joystick button state
    if(currentButtonState != lastButtonState[button])
#ifdef axisFlip
      if (button == axisFlip ) { //change x/y axis
        xAxis = !xAxis;
        yAxis = !yAxis;
      } else
#endif
        Joystick.setButton(button, !currentButtonState);

    //Save the last button state for each button for next time
    lastButtonState[button] = currentButtonState;

    ++button;
  } while (button < maxBut);
}

CraigB-spinner, 2025-02-22:
Does it work?
I used the A0-A4 ports for digital output to drive an RGB light under my Trackball.
I thought A0-A4 were analog only input storing value in a register 0-1023 or something like that.
My mod code temporary switches 4 of the buttons into d-pad/joystick to navigate in Retropie.
I used an unused button D14 to toggle the status using a capacitive touch board TTP223 (high +5V/low 0V).

Thread 5 (2025-09-03):

Missing Spinner_8-Button-Ratio-mod.ino for KY-040 encoder (360ppr)

btkyoung, 2025-09-03:
Hi, you are missing the Spinner_8-Button-Ratio-mod.ino listed in the README.md.
I am looking to use the small ardunio encoder module (KY-040) with Retropie instead of the larger optical encoder as i will have limited space on my build.

Is there any issues in using this encoder that you can see?
