CraigB-spinner/Arcade-Spinner/Spinner_8-Button-mod.ino

/*   Arcade Spinner v2.01
*    Mouse and Joystick (Arcade Spinner) version with Joystick override using buttons for menu navigation.
*    Craig B  - (craigbspinner@gmail.com)    
*    Copyright 2020 Craig B - based on Spinner code from early June 2019 
*                   Craig B - Updated code from late June 2019, 
*                             Added spinner movement ACCM/DROP, 
*                             Optimized code speed by changing if logic to case statement logic for Button validation of port bits.
*                   Craig B - Added code for spinner movement NORM/ACCS/ACCX, RetroPi fix - July 2019         
*                   Craig B - Added code for spinner axis change from early Sept 2020   
*                   Craig B - Added code for joystick override using buttons from mid Dec 2020   
*    
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
*    You should have received a copy of the GNU General Public License
*    along with this program.  If not, see <https://www.gnu.org/licenses/>.
*/

#include "Mouse.h"
#include <Joystick.h>

/*   RetroPie mods - Arduino IDE -> Tools, Get Board Info
*    VID: 1B4F
*    PID: 9206
*    Add the following to /boot/cmdline.txt -- just add a space to the end of the existing entry, so it is all on one line):
*    usbhid.quirks=0x16c0:0x05e1:0x040
*    The first two numbers are the vendor ID 16c0 and product ID 05e1.
*/

// Port Bit/Pin layout   
//      Bit -  76543210 - Silk screen ## - Micro-Controller
#define xPD3 0b00001000 //Digital Pin 0  - Micro/PRO Micro - RX,  INT2
#define xPD2 0b00000100 //Digital Pin 1  - Micro/PRO Micro - TX,  INT3
#define xPD1 0b00000010 //Digital Pin 2  - Micro/PRO Micro - SDA, INT0
#define xPD0 0b00000001 //Digital Pin 3  - Micro/PRO Micro - SCL, INT1
#define xPD_10 (xPD1 | xPD0)
#define xPD_32 (xPD3 | xPD2)
#define xPD4 0b00010000 //Digital Pin 4  - Micro/PRO Micro
#define xPC6 0b01000000 //Digital Pin 5  - Micro/PRO Micro
#define xPD7 0b10000000 //Digital Pin 6  - Micro/PRO Micro
#define xPE6 0b01000000 //Digital Pin 7  - Micro/PRO Micro
#define xPB4 0b00010000 //Digital Pin 8  - Micro/PRO Micro
#define xPB5 0b00100000 //Digital Pin 9  - Micro/PRO Micro
#define xPB6 0b01000000 //Digital Pin 10 - Micro/PRO Micro
#define xPB7 0b10000000 //Digital Pin 11 - Micro
#define xPD6 0b01000000 //Digital Pin 12 - Micro
#define xPC7 0b10000000 //Digital Pin 13 - Micro
#define xPB3 0b00001000 //Digital Pin 14 - PRO Micro
#define xPB1 0b00000010 //Digital Pin 15 - PRO Micro
#define xPB2 0b00000100 //Digital Pin 16 - PRO Micro
    
//Mouse movement - pick one to compile specific code inside loop()
//#define NORM   //Mouse movement Normal; every interrupt processed; maybe lag in fast movement, 2 pulse = 2 move
//#define DROP   //Mouse movement Drop; drop extra interrupts processed; smooth movement, no lag, 2 - 2n+1 pulse = 1 move
//#define ACCS   //Mouse movement Accelerated; every interrupt processed but accelerated movement, no lag x1, 1 pulse = 1 move 
#define ACCM   //Mouse movement Accelerated; every interrupt processed but accelerated movement, no lag x2, 2 pulse = 1 move
//#define ACCX   //Mouse movement Accelerated; every interrupt processed but accelerated movement, no lag x4, 4 pulse = 1 move

#define pinA 2    //The pins that the rotary encoder's A and B terminals are connected to.
#define pinB 3

#define maxBut 10     //Update lastButtonState array below when changing number of elements.
//#define axisFlip 6  //Special flip button (button offset: 0 thru 9) - comment out if 'x-axis disable' feature not required by you.
#define joyStmp  7  //Special temp JoyStick override button (button offset: 0 thru 9) - comment out if 'JoyStick override' feature not required by you.

#ifdef joyStmp
int joyStOn = 1;      //Joystick override status of button - off
#endif
#define butPrs 0      //Button pulled low when pressed
#define butOff 1      //Button pullup high when not pressed

//#define TEST        //Display info on Serial Monitor
 
//Create a Joystick object.
Joystick_ Joystick(JOYSTICK_DEFAULT_REPORT_ID,JOYSTICK_TYPE_GAMEPAD,
  maxBut, 0,             // Button Count, Hat Switch Count
  true, true, false,    // X, but no Y or Z Axis. We need at least one axis even though it's not really used.
  false, false, false,   // No Rx, Ry, or Rz
  false, false,          // No rudder or throttle
  false, false, false);  // No accelerator, brake, or steering;

//The previous state of the AB pins
volatile int prevQuadratureX = 0;

//Keeps track of how much the encoder has been moved
volatile int rotPositionX = 0;
volatile int rotMultiX = 0;
#ifdef axisFlip
volatile int xAxis = 1; 
volatile int yAxis = 0; 

// Last state of 10 buttons (update array for your maxBut buttons)
// Since Button Port Bits are set to 1 to activate(pull-hi input resistors), 
// the press state is low, and not pressed is high.
// axisFlip 6, joyStmp 7 (button offset: 0 thru 9)
#ifdef joyStmp
int lastButtonState[maxBut] = {1,1,1,1,1,1,1,1,1,1};
#else
int lastButtonState[maxBut] = {1,1,1,1,1,1,1,0,1,1};
#endif
#elif joyStmp
int lastButtonState[maxBut] = {1,1,1,1,1,1,0,1,1,1};
#else
int lastButtonState[maxBut] = {1,1,1,1,1,1,0,0,1,1};
#endif


void setup() {
  //No need to set the pin modes with DDRx = DDRx | 0b00000000 as we're using all input and that's the initial state of the pins
  //Setup for three mouse buttons Left, Centre, Right, plus special axisFlip control.
  //Use internal input resistors for all the pins we're using - pull high resistor, when button pressed (short to ground) input on pin is pulled low.
  //Digital pin D# corresponds to silk screen on micro-controller board, (#) corresponds to port bit internal use MSD(7)-to-LSD(0) - you assign button # in code 
  PORTD = 0b10010011; //Digital pins D2(1), D3(0), D4(4), and D6(7). - Spinner x-axis only, and (Button 1 & 3)
//PORTB = 0b01110111; //Digital pins D8(4), D9(5), D10(6), and D15(1). {D16(2), D14(3)}; D16 requires PB0 set high(master) - (Button 5, 6, 9 & 10)
#ifdef axisFlip       // D16 - PB2 & PB0 hi
#ifdef joyStmp        // D14 - PB3 hi
  PORTB = 0b01111111; //(Button 5, 6, 7-Axis, 8-Joys, 9 & 10)
#else
  PORTB = 0b01110111; //(Button 5, 6, 7-Axis, 9 & 10)
#endif
#elif joyStmp
  PORTB = 0b01111010; //(Button 5, 6, 8-Joys, 9 & 10)
#else
  PORTB = 0b01110010; //(Button 5, 6, 9 & 10)
#endif 
  PORTC = 0b01000000; //Digital pin D5(6) - (Button 2) 
  PORTE = 0b01000000; //Digital pin D7(6) - (Button 4)
//PORTF = 0b11000000; //Digital pin A0(7) & A1(6). A2(5), A3(4) 

  //Start the joystick
  Joystick.begin();
  
  //Center the X axis on the joystick (Raspberry Pi/RetroPi requires two axises to be defined)
  Joystick.setXAxis(511);
  Joystick.setYAxis(511);

#ifdef TEST
  Serial.begin(9600); //This pipes to the serial monitor
#endif

  //Set up the interrupt handler for the encoder's A and B terminals on digital pins 2 and 3 respectively. Both interrupts use the same handler.
  attachInterrupt(digitalPinToInterrupt(pinA), pinChangeX, CHANGE); 
  attachInterrupt(digitalPinToInterrupt(pinB), pinChangeX, CHANGE);

  //Start the mouse
  Mouse.begin();
  }

//---------------------------------------------------------------------
//Interrupt handler x-axis
void pinChangeX() {

  //Set currQuadratureX to state of rotary encoder terminals A & B from input of PORTD bits 0 & 1 (digital pins 2 and 3)
  //You could do int currQuadratureX = (digitalRead(pinA) << 1) | digitalRead(pinB); to get the same thing, but it would be much slower.
  //Read current state 00AB.
  int currQuadratureX = PIND & xPD_10;

  //Store comboQuadratureX with previous and current quadrature rotary encoder states together. 
  //Combined previous/current states form two groups of four unique bit patterns indicating direction of movement.
  //Shift left 2 bits: 00AB <- AB00 to store current state as previous state.
  int comboQuadratureX  = (prevQuadratureX << 2) | currQuadratureX; 

  //Rotate to the right, Clockwise
  //State 00AB, A leads B. A0 -> AB -> 0B -> 00 0b0010 0b1011 0b1101 0b0100
  if(comboQuadratureX == 0b0010 || comboQuadratureX == 0b1011 ||
     comboQuadratureX == 0b1101 || comboQuadratureX == 0b0100) 
    rotPositionX++;                   //update the position of the encoder

  //Rotate to the left, Counter Clockwise
  //State 00AB, B leads A. 0B -> AB -> A0 -> 00 0b0001 0b0111 0b1110 0b1000
  if(comboQuadratureX == 0b0001 || comboQuadratureX == 0b0111 ||
     comboQuadratureX == 0b1110 || comboQuadratureX == 0b1000) 
    rotPositionX--;                   //update the position of the encoder
 
  //Save the previous state of the A and B terminals for next time
  prevQuadratureX = currQuadratureX;
}


//---------------------------------------------------------------------
//Process the x/y axis mouse movement using one criteria (NORM, DROP, ACCS, ACCM, ACCX)
//most criteria process two edge transistions before moving the mouse/spinner pointer.
//Then cycle thru eight button states 1, 2, 3, 4, 5, 6, Coin(9), Start(10), to trigger button press/release on joystick
void loop(){ 
  int currentButtonState;

// *** Spinner movement logic ***
#ifdef NORM
  //If the encoder has moved 2 or more transitions move the mouse in the appropriate direction 
  //and update the position variable to reflect that we moved the mouse. Smooth movement but lags.
  if(rotPositionX >= 2) {
  #ifdef axisFlip
    Mouse.move(xAxis,yAxis,0);
  #endif 
  #ifndef axisFlip
    Mouse.move(1,0,0);
  #endif 
    rotPositionX -= 2;
  } else if(rotPositionX <= -2) {
  #ifdef axisFlip
    Mouse.move(-xAxis,-yAxis,0);
  #endif 
  #ifndef axisFlip
    Mouse.move(-1,0,0);
  #endif 
    rotPositionX += 2;
  } 
#endif 

#ifdef DROP
  //If the encoder has moved 2 or more transitions move the mouse in the appropriate direction 
  //and update the position variable to reflect that we moved the mouse. Smooth drop extra moves.
  if(rotPositionX >= 2) {
  #ifdef axisFlip
    Mouse.move(xAxis,yAxis,0);
  #endif 
  #ifndef axisFlip
    Mouse.move(1,0,0);
  #endif 
    rotPositionX = 0;
  } else if(rotPositionX <= -2) {
  #ifdef axisFlip
    Mouse.move(-xAxis,-yAxis,0);
  #endif 
  #ifndef axisFlip
    Mouse.move(-1,0,0);
  #endif 
    rotPositionX = 0;
  } 
#endif 

#ifdef ACCS
  //If the encoder has moved 1 or more transitions move the mouse in the appropriate direction 
  //and update the position variable to reflect that we moved the mouse. Accelerated move.
  if(rotPositionX  != 0) {
  #ifdef axisFlip
    int x = (xAxis) ? rotPositionX : 0;
    int y = (yAxis) ? rotPositionX : 0;
    Mouse.move(x,y,0);
  #endif 
  #ifndef axisFlip
    Mouse.move(rotPositionX ,0,0);
  #endif 
    rotPositionX  = 0;
  }
#endif 

#ifdef ACCM
  //If the encoder has moved 2 or more transitions move the mouse in the appropriate direction 
  //and update the position variable to reflect that we moved the mouse. Accelerated move.
  if(rotPositionX >= 2 || rotPositionX <= -2) {
    rotMultiX = rotPositionX >> 1;
  #ifdef axisFlip
    int x = (xAxis) ? rotMultiX : 0;
    int y = (yAxis) ? rotMultiX : 0;
    Mouse.move(x,y,0);
  #endif 
  #ifndef axisFlip  
    Mouse.move(rotMultiX,0,0);
  #endif 
    rotPositionX -= (rotMultiX << 1);
  }
#endif 

#ifdef ACCX
  //If the encoder has moved 4 or more transitions move the mouse in the appropriate direction 
  //and update the position variable to reflect that we moved the mouse. Accelerated move.
  if(rotPositionX >= 4 || rotPositionX <= -4) {
    rotMultiX = rotPositionX >> 2;
  #ifdef axisFlip
    int x = (xAxis) ? rotMultiX : 0;
    int y = (yAxis) ? rotMultiX : 0;
    Mouse.move(x,y,0);
  #endif 
  #ifndef axisFlip
    Mouse.move(rotMultiX,0,0);
  #endif 
    rotPositionX -= (rotMultiX << 2);
  }
#endif 
// *** Spinner movement logic ***


//---------------------------------------------------------------------------------------------------
//---------------------------------------------------------------------------------------------------
  //Iterate through 10 buttons (0-9) assigning current digital state of pin for each button. 
  //Button returns HIGH(0b00000001) when NOT PRESSED, 
  //            or LOW (0b00000000) when PRESSED, and stored to currentButtonState variable. 
  //Note: Pro Micro boards use various ports to access different digital pins. 
  //Buttons 1-6, plus 9-select(coin), and 10-start(player) used; buttons 7 & 8 unused
  //Using digital pins 4, 5, 6, 7, 8, 9, 10, and 15 on Pro Micro board. See silk screening.
  //Pins 16 and 14 are free to use. (assigned to special features)
  //Pins 2 and 3 are used for spinner rotary output as they are interrupt driven.
  int button = 0;
  do {
    switch ( button ) {
      case 0:  //on digital pin 4, PD4 - Arcade Button 1 - X
        currentButtonState = (PIND & xPD4) >> 4;
        break;
      case 1:  //on digital pin 5, PC6 - Arcade Button 2 - A
        currentButtonState = (PINC & xPC6) >> 6;
        break;
      case 2:  //on digital pin 6, PD7 - Arcade Button 3 - B
        currentButtonState = (PIND & xPD7) >> 7;
        break;
      case 3:  //on digital pin 7, PE6 - Arcade Button 4 - Y
        currentButtonState = (PINE & xPE6) >> 6;
        break;
      case 4:  //on digital pin 8, PB4 - Arcade Button 5 - L
        currentButtonState = (PINB & xPB4) >> 4;
        break;
      case 5:  //on digital pin 9, PB5 - Arcade Button 6 - R
        currentButtonState = (PINB & xPB5) >> 5;
        break;
    #ifdef axisFlip
      case 6:  //on digital pin 16, PB2 - Special Axis Button (internal function) - requires PB0 set to master or high
        currentButtonState = (PINB & xPB2) >> 2;
        break; 
    #endif
    #ifdef joyStmp
      case 7:  //on digital pin 14, PB3 - 2nd Special Button 
        currentButtonState = (PINB & xPB3) >> 3;
        break; 
    #endif
      case 8:  //on digital pin 10, PB6 - COIN/Select Button 9
        currentButtonState = (PINB & xPB6) >> 6;
        break;
      case 9:  //on digital pin 15, PB1 - PLAYER/Start Button 10
        currentButtonState = (PINB & xPB1) >> 1;
        break; 
      default: //Extra digital pins 16, PB2 and 14, PB3
        currentButtonState = 0b00000000;
        break;
    }
    
//#ifdef TEST
//  Serial.print("Button: ");
//  Serial.print(button);  
//  Serial.print(" = ");
//  Serial.print(currentButtonState);  
//  Serial.println(" --");
//#endif   
   
//If the current state of the pin for each button is different than last time, update the joystick button state
    if(currentButtonState != lastButtonState[button]) { //change in button
  #ifdef axisFlip
      if (button == axisFlip ) { //change x/y axis
        xAxis = !xAxis;
        yAxis = !yAxis;
      } else
  #endif

// *** Temporary joystick logic ***
  #ifdef joyStmp
      if (button == joyStmp ) { //change buttons to tmp joystick
        joyStOn = !joyStOn;
      }

// Joystick axis value range
//(Lo) 0 - 511 - 1023 (Hi)
      if ( joyStOn == butPrs) { //temp Joystick override activated
        if (currentButtonState != lastButtonState[button]) {
          switch ( button ) {
            case 2: // LEFT
              if (currentButtonState == butOff) 
                Joystick.setXAxis(511);
              else 
                Joystick.setXAxis(0);
              break;
            case 3: // UP
              if (currentButtonState == butOff) 
                Joystick.setYAxis(511);
              else 
                Joystick.setYAxis(0);
              break;
            case 4: // RIGHT
              if (currentButtonState == butOff) 
                Joystick.setXAxis(511);
              else 
                Joystick.setXAxis(1023);
              break;
            case 5: // DOWN
              if (currentButtonState == butOff) 
                Joystick.setYAxis(511);
               else 
                Joystick.setYAxis(1023);
              break;
            default: //Extra digital pins
              if (button == 0) 
                 Joystick.setButton(2, !currentButtonState); //Button 3(B) is used for Left, set Button 1 as B
               else 
                 Joystick.setButton(button, !currentButtonState);
              break;          
          }
        } 
      } else //joyStOn is off
      if (button == joyStmp ) {  //temp Joystick override disabled - center Joystick
        Joystick.setXAxis(511);
        Joystick.setYAxis(511);
      }

      if ( joyStOn == butOff ) 
  #endif
// *** Temporary joystick logic ***
        Joystick.setButton(button, !currentButtonState);
    }
    
    //Save the last button state for each button for next time
    lastButtonState[button] = currentButtonState;

    ++button;
  } while (button < maxBut);
}
  
