CraigB-spinner/Arcade-Spinner/(commit log)

2020-12-11 Special Mouse only (Arcade Spinner) version.
    Special Mouse only (Arcade Spinner) version -
    with & without mouse Left/Centre/Right buttons,
    plus 'with' version able to switch x/y axis using forth button.
2020-12-11 Mouse and Joystick (Arcade Spinner) version.
    Mouse and Joystick (Arcade Spinner) version.
    Mouse horizontal default (Arcade Spinner) version -
    plus directive to switch between x/y axis using special button.
2020-12-17 Mouse and Joystick (Arcade Spinner) Mod version.
    Mouse horizontal default (Arcade Spinner) Mod version -
    plus directive to switch between x/y axis using special button,
    and directive to switch to Joystick (button) directions using special button.
2022-12-20 Mouse and Joystick (Arcade Spinner) MiSTer Vari-Speed version.
    Mouse horizontal default (Arcade Spinner) MiSTer-Mod version -
    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
2023-03-07 Special No button (Arcade Spinner) version.
    Special No button (Arcade Spinner) version -
    plus able to switch x/y axis using Pins D16 or D17 button.
2023-11-11 Debug code with minor errors
    Low voltage, missing single A or B signal connection - Both A/B and +5V & Gnd must be in proper spec to respond as a mouse without hesitation.
    [Spinner_Debug.ino]
